IAD-ZHDK/NetStepper/README.md

# Net Stepper

**A networked stepper motor controller.**
