IAD-ZHDK/NetStepper/PositionSensor/PositionSensor.brd

## EAGLE design PositionSensor/PositionSensor.brd (2017-03-13)

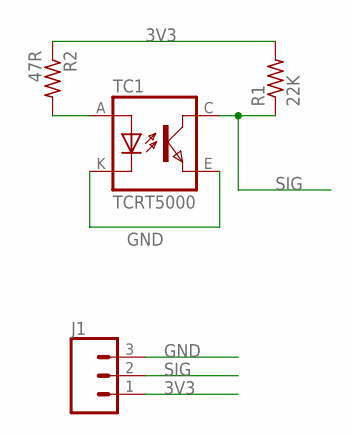
[picture p1: schematic PositionSensor.sch]

Parts:
J1: CONN_03LONGPADS; 1X03_LONGPADS
R1: 22K; 0204/7
R2: 47R; 0204/7
TC1: TCRT5000

Connections:
3V3: J1.1, R1.2, R2.1
GND: J1.3, TC1.E (EMITTER), TC1.K (CATHODE)
unnamed: R2.2, TC1.A (ANODE)
SIG: J1.2, R1.1, TC1.C (COLLECTOR)

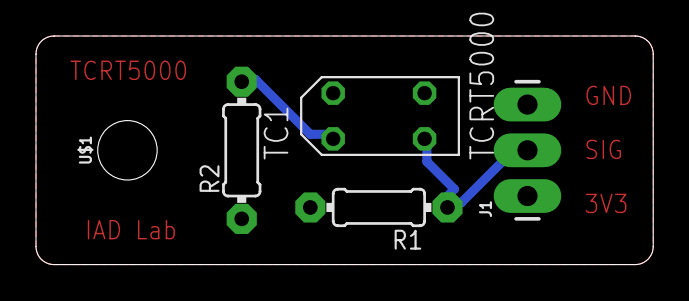
[picture p2: board PositionSensor.brd from above]

Board: 2 copper layers, 34.3 x 12.7 mm, 5 parts (0 on the bottom side), 4 nets.

Other parts of the board:
U$1: STAND-OFF
