IAD-ZHDK/NetStepper/Controller/Controller.brd

## EAGLE design Controller/Controller.brd (2017-03-16)

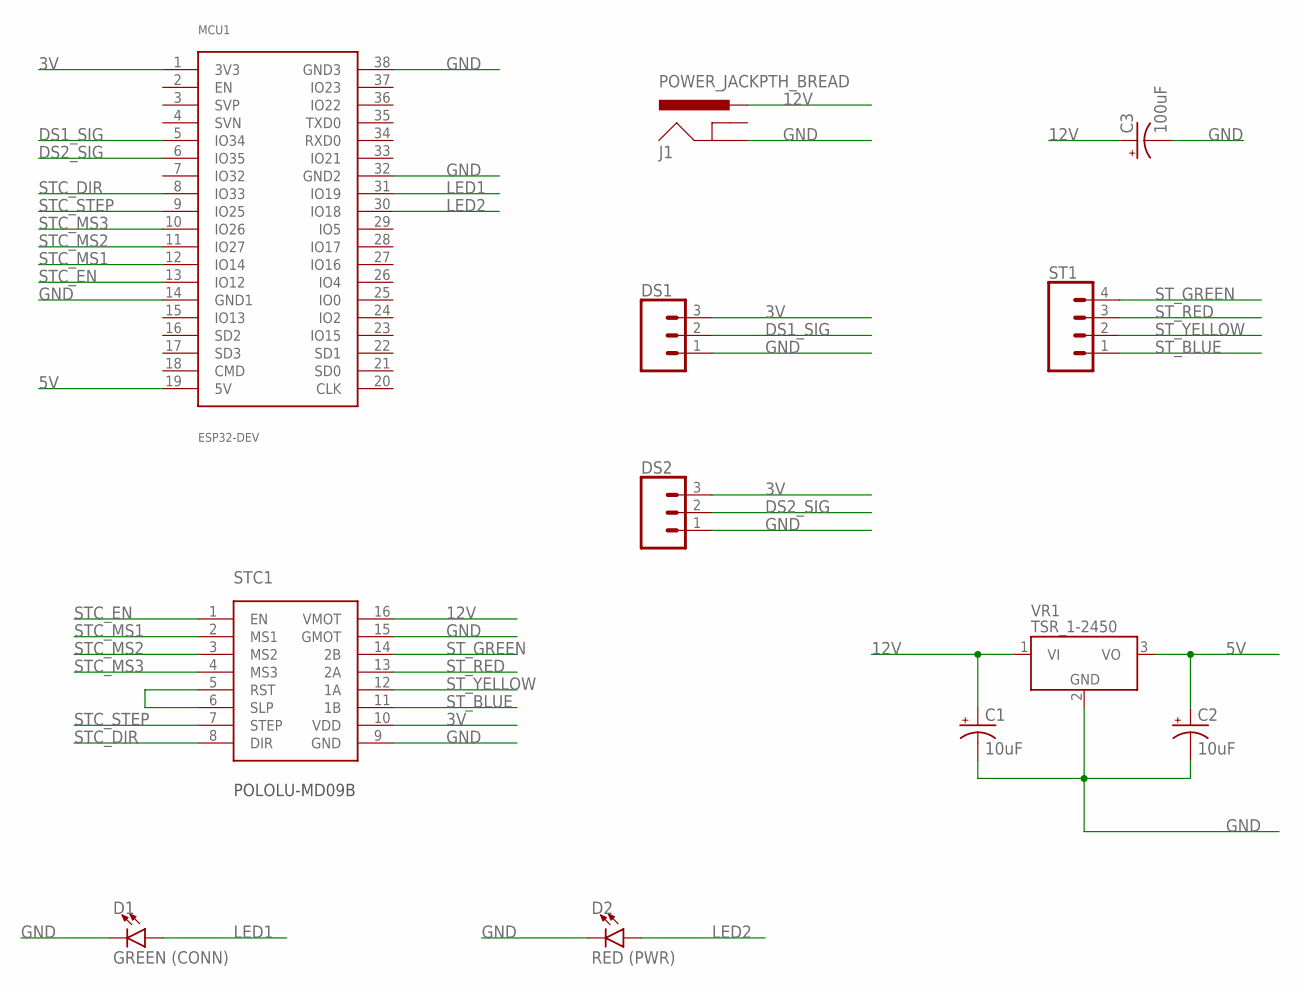
[picture p3: schematic Controller.sch]

Parts:
C1, C2: 10uF; E2-5
C3: 100uF; E2-5
D1: GREEN (CONN); LED_5MM
D2: RED (PWR); LED_5MM
DS1, DS2: CONN_03LONGPADS; 1X03_LONGPADS
J1: POWER_JACKPTH_BREAD; POWER_JACK_PTH_BREAD
MCU1: ESP32-DEV
ST1: CONN_04LONGPADS; 1X04_LONGPADS
STC1: POLOLU-MD09B
VR1: TSR_1-2450; TSR-1

Connections:
3V: DS1.3, DS2.3, MCU1.1 (3V3), STC1.10 (VDD)
5V: C2.+, MCU1.19 (5V), VR1.3 (VO)
12V: C1.+, C3.+, J1.PWR, STC1.16 (VMOT), VR1.1 (VI)
DS1_SIG: DS1.2, MCU1.5 (IO34)
DS2_SIG: DS2.2, MCU1.6 (IO35)
GND: C1.-, C2.-, C3.-, D1.K (C), D2.K (C), DS1.1, DS2.1, J1.GND, MCU1.14 (GND1), MCU1.32 (GND2), MCU1.38 (GND3), STC1.9 (GND), STC1.15 (GMOT), VR1.2 (GND)
LED1: D1.A, MCU1.31 (IO19)
LED2: D2.A, MCU1.30 (IO18)
unnamed: STC1.5 (RST), STC1.6 (SLP)
STC_DIR: MCU1.8 (IO33), STC1.8 (DIR)
STC_EN: MCU1.13 (IO12), STC1.1 (EN)
STC_MS1: MCU1.12 (IO14), STC1.2 (MS1)
STC_MS2: MCU1.11 (IO27), STC1.3 (MS2)
STC_MS3: MCU1.10 (IO26), STC1.4 (MS3)
STC_STEP: MCU1.9 (IO25), STC1.7 (STEP)
ST_BLUE: ST1.1, STC1.11 (1B)
ST_GREEN: ST1.4, STC1.14 (2B)
ST_RED: ST1.3, STC1.13 (2A)
ST_YELLOW: ST1.2, STC1.12 (1A)

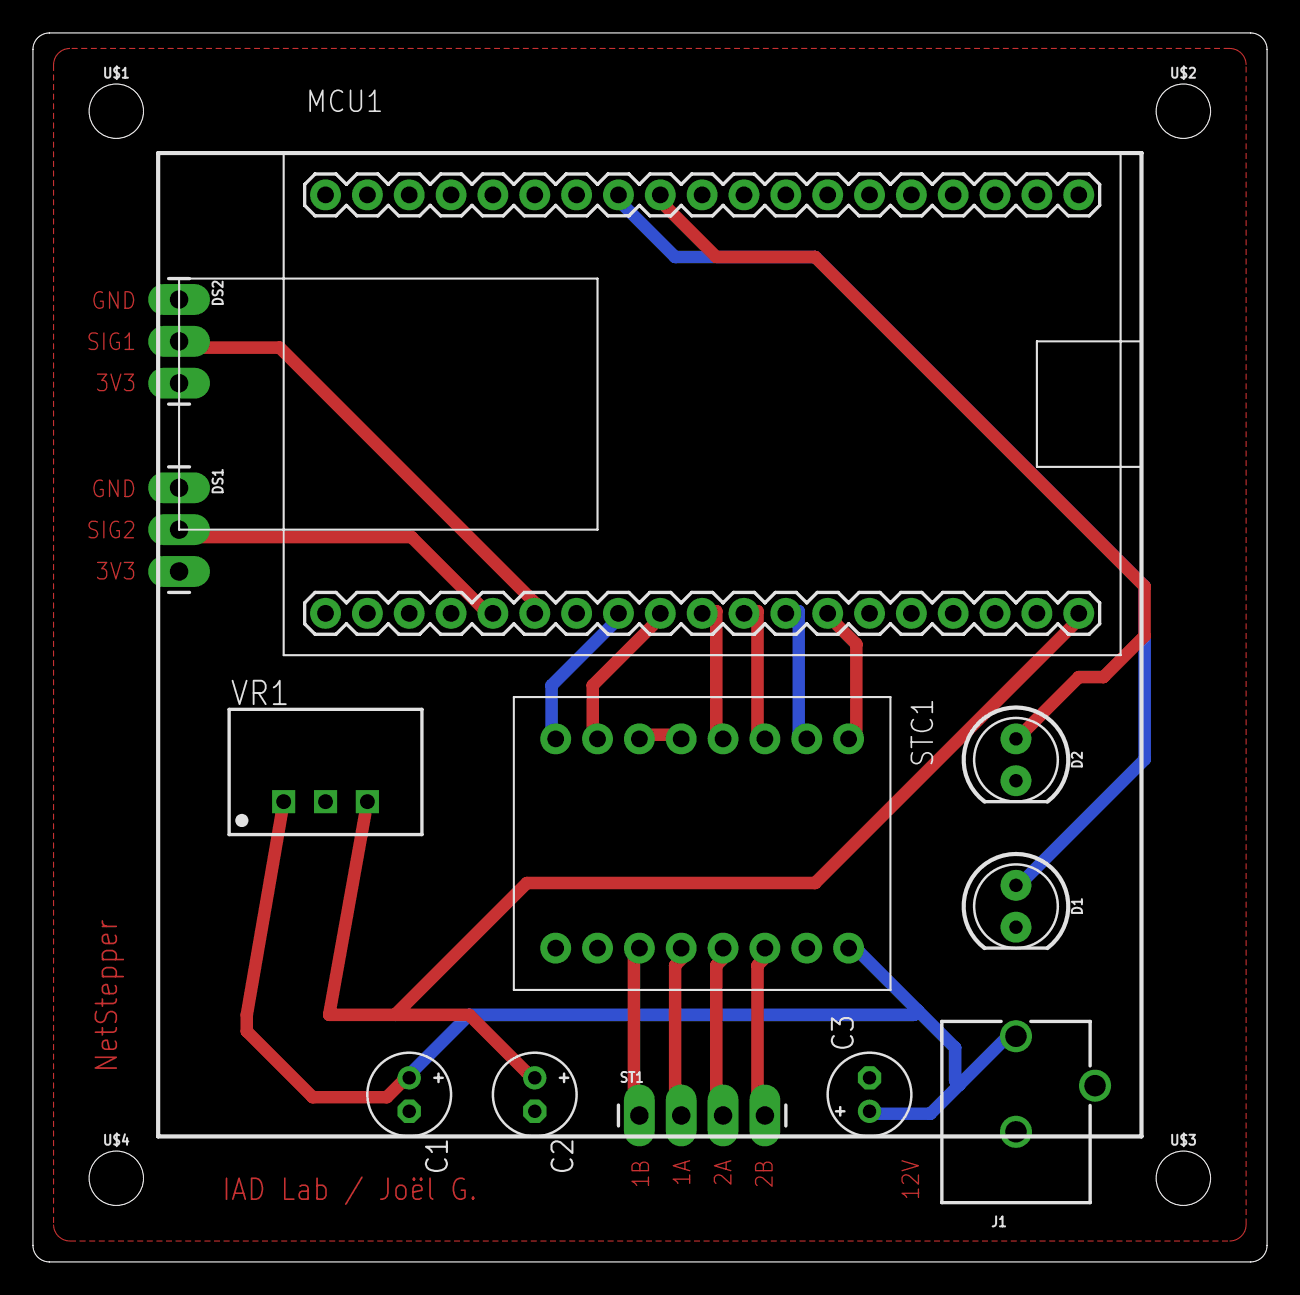
[picture p4: board Controller.brd from above]

Board: 2 copper layers, 74.9 x 74.6 mm, 16 parts (0 on the bottom side), 19 nets.

Other parts of the board:
U$1, U$2, U$3, U$4: STAND-OFF
