IAD-ZHDK/NetStepper/Boards/Controller2/Controller2.brd

## EAGLE design Boards/Controller2/Controller2.brd (2017-02-15)

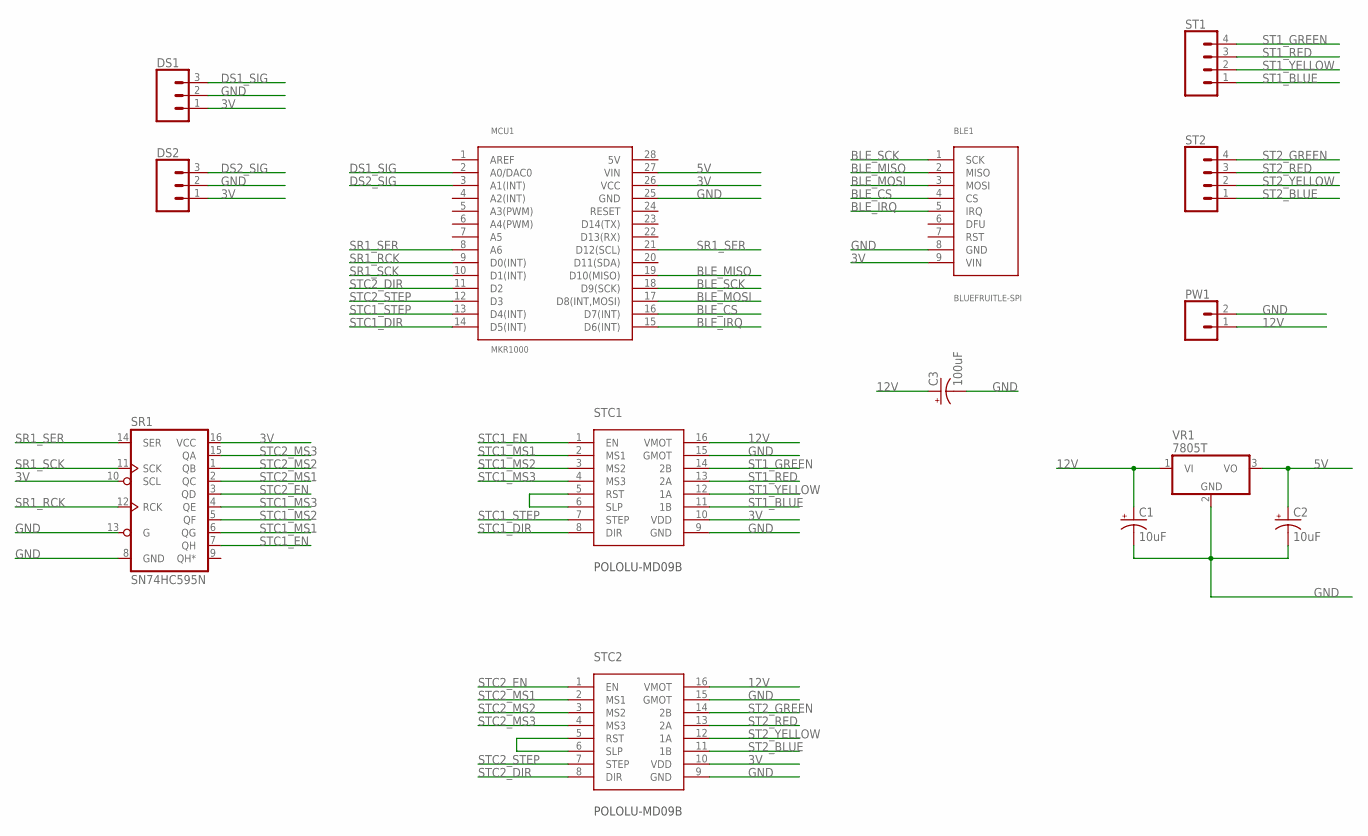
[picture p5: schematic Controller2.sch]

Parts:
BLE1: BLUEFRUITLE-SPI; BLUEFRUITLE-SPI-SOCKET
C1, C2: 10uF; E2-5
C3: 100uF; E2-5
DS1, DS2: CONN_03LONGPADS; 1X03_LONGPADS
MCU1: MKR1000; MKR1000-SOCKET
PW1: CONN_025MM; SCREWTERMINAL-5MM-2
SR1: SN74HC595N; DIP16
ST1, ST2: CONN_04LONGPADS; 1X04_LONGPADS
STC1, STC2: POLOLU-MD09B
VR1: 7805T; TO220H

Connections:
3V: BLE1.9 (VIN), DS1.1, DS2.1, MCU1.26 (VCC), SR1.10 (SCL), SR1.16 (VCC), STC1.10 (VDD), STC2.10 (VDD)
5V: C2.+, MCU1.27 (VIN), VR1.3 (VO)
12V: C1.+, C3.+, PW1.1, STC1.16 (VMOT), STC2.16 (VMOT), VR1.1 (VI)
BLE_CS: BLE1.4 (CS), MCU1.16 (D7(INT))
BLE_IRQ: BLE1.5 (IRQ), MCU1.15 (D6(INT))
BLE_MISO: BLE1.2 (MISO), MCU1.19 (D10(MISO))
BLE_MOSI: BLE1.3 (MOSI), MCU1.17 (D8(INT,MOSI))
BLE_SCK: BLE1.1 (SCK), MCU1.18 (D9(SCK))
DS1_SIG: DS1.3, MCU1.2 (A0/DAC0)
DS2_SIG: DS2.3, MCU1.3 (A1(INT))
GND: BLE1.8 (GND), C1.-, C2.-, C3.-, DS1.2, DS2.2, MCU1.25 (GND), PW1.2, SR1.8 (GND), SR1.13 (G), STC1.9 (GND), STC1.15 (GMOT), STC2.9 (GND), STC2.15 (GMOT), VR1.2 (GND)
unnamed: STC1.5 (RST), STC1.6 (SLP)
unnamed: STC2.5 (RST), STC2.6 (SLP)
SR1_RCK: MCU1.9 (D0(INT)), SR1.12 (RCK)
SR1_SCK: MCU1.10 (D1(INT)), SR1.11 (SCK)
SR1_SER: MCU1.8 (A6), MCU1.21 (D12(SCL)), SR1.14 (SER)
ST1_BLUE: ST1.1, STC1.11 (1B)
ST1_GREEN: ST1.4, STC1.14 (2B)
ST1_RED: ST1.3, STC1.13 (2A)
ST1_YELLOW: ST1.2, STC1.12 (1A)
ST2_BLUE: ST2.1, STC2.11 (1B)
ST2_GREEN: ST2.4, STC2.14 (2B)
ST2_RED: ST2.3, STC2.13 (2A)
ST2_YELLOW: ST2.2, STC2.12 (1A)
STC1_DIR: MCU1.14 (D5(INT)), STC1.8 (DIR)
STC1_EN: SR1.7 (QH), STC1.1 (EN)
STC1_MS1: SR1.6 (QG), STC1.2 (MS1)
STC1_MS2: SR1.5 (QF), STC1.3 (MS2)
STC1_MS3: SR1.4 (QE), STC1.4 (MS3)
STC1_STEP: MCU1.13 (D4(INT)), STC1.7 (STEP)
STC2_DIR: MCU1.11 (D2), STC2.8 (DIR)
STC2_EN: SR1.3 (QD), STC2.1 (EN)
STC2_MS1: SR1.2 (QC), STC2.2 (MS1)
STC2_MS2: SR1.1 (QB), STC2.3 (MS2)
STC2_MS3: SR1.15 (QA), STC2.4 (MS3)
STC2_STEP: MCU1.12 (D3), STC2.7 (STEP)

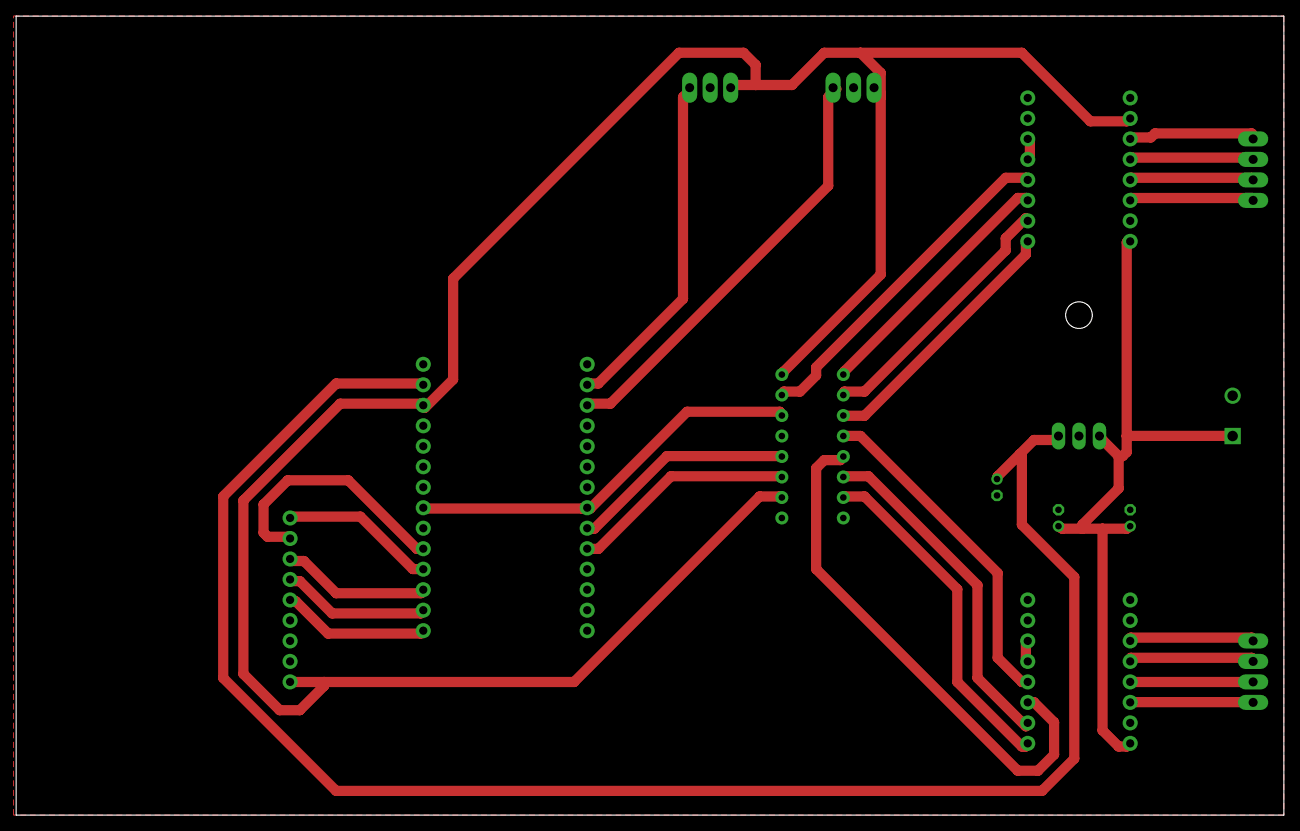
[picture p6: board Controller2.brd from above]

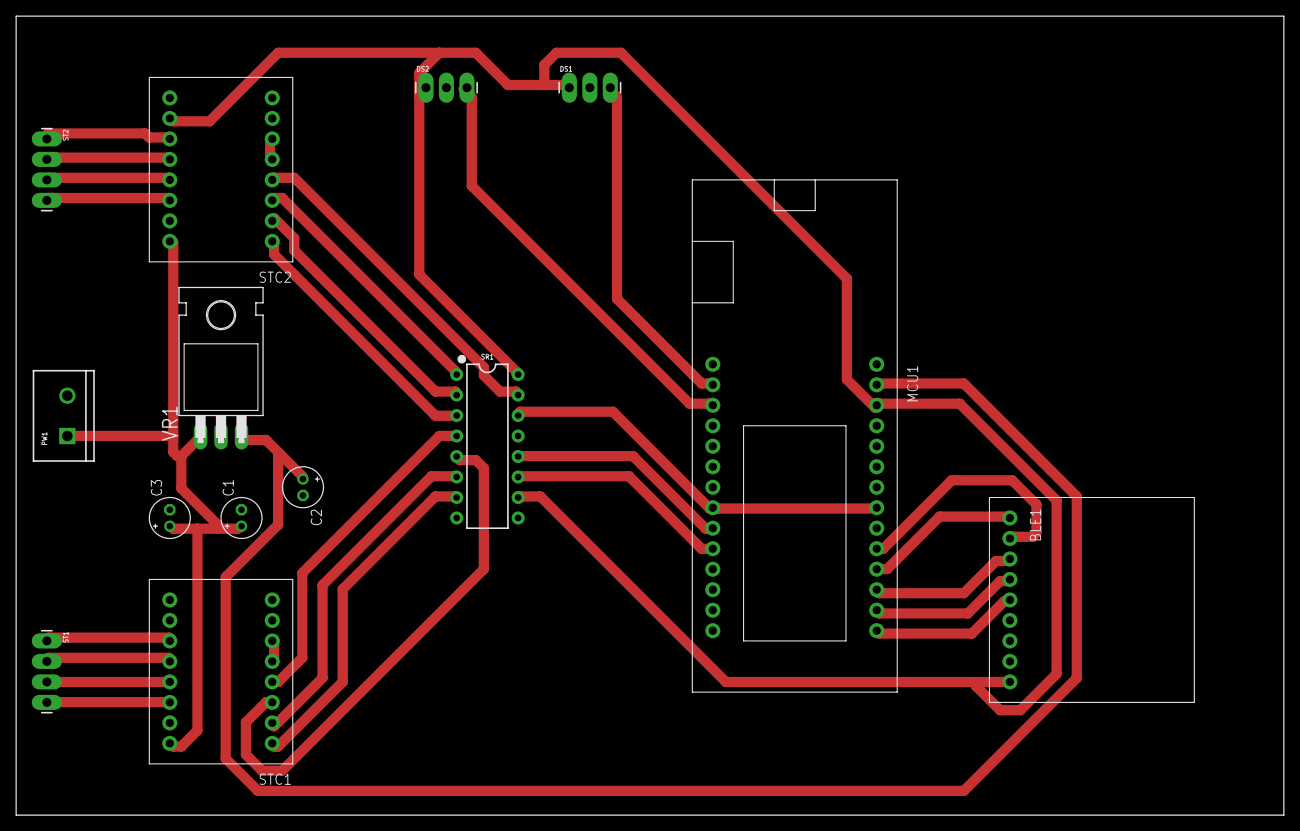
[picture p7: board Controller2.brd from below]

Board: 2 copper layers, 157.1 x 99.0 mm, 14 parts (14 on the bottom side), 36 nets.
