IAD-ZHDK/NetStepper/src/led.c

#include <driver/ledc.h>

#define LED_RED_PIN 18
#define LED_GREEN_PIN 19

void led_set(bool red, bool green) {
  // set duties
  ESP_ERROR_CHECK(ledc_set_duty(LEDC_HIGH_SPEED_MODE, LEDC_CHANNEL_0, red ? 512 : 0));
  ESP_ERROR_CHECK(ledc_set_duty(LEDC_HIGH_SPEED_MODE, LEDC_CHANNEL_1, green ? 512 : 0));

  // update channels
  ESP_ERROR_CHECK(ledc_update_duty(LEDC_HIGH_SPEED_MODE, LEDC_CHANNEL_0));
  ESP_ERROR_CHECK(ledc_update_duty(LEDC_HIGH_SPEED_MODE, LEDC_CHANNEL_1));
}

void led_init() {
  // prepare ledc timer config
  ledc_timer_config_t t = {
      .bit_num = LEDC_TIMER_10_BIT, .freq_hz = 5000, .speed_mode = LEDC_HIGH_SPEED_MODE, .timer_num = LEDC_TIMER_0};

  // configure ledc timer
  ESP_ERROR_CHECK(ledc_timer_config(&t));

  // prepare ledc channel config
  ledc_channel_config_t c = {
      .duty = 0, .intr_type = LEDC_INTR_DISABLE, .speed_mode = LEDC_HIGH_SPEED_MODE, .timer_sel = LEDC_TIMER_0};

  // configure red led
  c.gpio_num = LED_RED_PIN;
  c.channel = LEDC_CHANNEL_0;
  ESP_ERROR_CHECK(ledc_channel_config(&c));

  // configure green led
  c.gpio_num = LED_GREEN_PIN;
  c.channel = LEDC_CHANNEL_1;
  ESP_ERROR_CHECK(ledc_channel_config(&c));
}
