IAD-ZHDK/NetStepper/(commit log)

2017-02-15 added boards
    [Controller1.brd, Controller1.sch, Controller2.brd, Controller2.sch, PositionSensor.brd, PositionSensor.sch]
2017-02-15 removed obsolete signals
    [Controller1.brd, Controller1.sch]
2017-02-16 emit sensor reading
2017-02-16 renamed enable to power
2017-02-24 updated position sensor
    [PositionSensor.brd]
2017-02-24 cleaned up some stuff
    [Controller.brd, Controller.sch, ControllerESP32.brd, ControllerESP32.sch]
2017-03-02 finished esp32 based board
    [ControllerESP32.brd, ControllerESP32.sch]
2017-03-02 finish esp32 based controller
    [ControllerESP32.brd, ControllerESP32.sch]
2017-03-13 finished esp32 board based board
    [ControllerESP32.brd, ControllerESP32.sch]
2017-03-13 finished for mass production
    [PositionSensor.brd, PositionSensor.sch]
2017-03-13 finished controller for mass production
    [Controller.brd, Controller.sch, ControllerESP32.brd, ControllerESP32.sch]
2017-03-16 changed labels
    [Controller.brd]
2017-03-16 use stepping voltage regulator instead of a linear
    [Controller.brd, Controller.sch]
2017-03-26 moved files
    [Controller.brd, Controller.sch, PositionSensor.brd, PositionSensor.sch]
2017-06-30 added net stepper firmware source code
2017-07-03 added missing firmware version
    [main.c]
